Emile666/Brew_HW_Stm8s207/img/brew_hw_stm8s207_v401.png

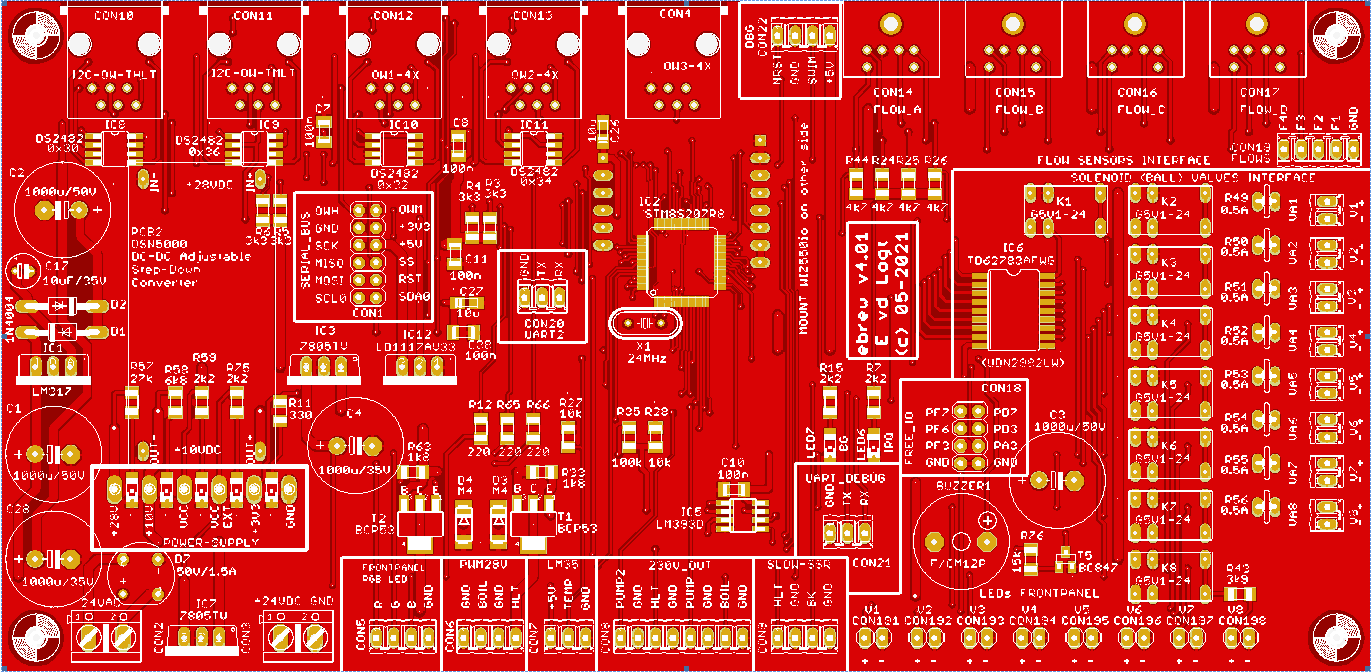
img/brew_hw_stm8s207_v401.png
