Emile666/Brew_HW_Stm8s207/pwm.c

/*==================================================================
  File Name: pwm.c
  Author   : Emile
  ------------------------------------------------------------------
  Purpose  : STM8 PWM routines
  ------------------------------------------------------------------
  This file is free software: you can redistribute it and/or modify
  it under the terms of the GNU General Public License as published by
  the Free Software Foundation, either version 3 of the License, or
  (at your option) any later version.
 
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
  You should have received a copy of the GNU General Public License
  along with this software.  If not, see <http://www.gnu.org/licenses/>.
  ================================================================== */ 
#include "pwm.h"

/*------------------------------------------------------------------
  Purpose  : This function writes a duty-cycle to a timer, so that a
             PWM signal is generated.
             There are two timers used, each with two channels:
             Timer 1, f = 16 kHz, used for the modulating gas-valves
             - channel 1: HLT_PWM
             - channel 2: BK_PWM
             Timer 3, f = 1 Hz, used for the slow-PWM/SSR signals
             - channel 1: HLT_SSR
             - channel 2: BK_SSR
             Both timers expect a duty-cycle in E-1 %.
  Variables:
       pwm_ch: [PWM_HLT, PWM_BK], the PWM timer to write to
   duty_cycle: The duty_cycle for the timers, value between [0%,100%]
  Returns  : -
  ------------------------------------------------------------------*/
void pwm_write(uint8_t pwm_ch, uint8_t duty_cycle) // duty_cyle varies 0 % and 100 %
{
    uint8_t lsb,msb;
    uint16_t temp;

    // A low-value pulls the base of the BC640 transistor low, so that
    // it starts to conducts. Inverted Logic!
    temp = 10 * (uint16_t)duty_cycle; // timers expect a duty-cycle in E-1 %.
    msb  = (temp >> 8);
    lsb  = temp & 0xFF;
    if (pwm_ch == PWM_HLT)
    {   // HLT
        TIM1_CCR1H = msb; //  msb, write this first
        TIM1_CCR1L = lsb; //  lsb
        TIM3_CCR1H = msb; //  msb, write this first
        TIM3_CCR1L = lsb; //  lsb
    } // if
    else
    {   // Boil-kettle
        TIM1_CCR2H = msb; //  msb, write this first
        TIM1_CCR2L = lsb; //  lsb
        TIM3_CCR2H = msb; //  msb, write this first
        TIM3_CCR2L = lsb; //  lsb
    } // else
} // pwm_write()
