Emile666/Brew_HW_Stm8s207/(commit log)

2023-03-26 All serial interfaces debugged and tested
    Works with PCB HW v4.01.
    Scheduler tasks now set correctly.
    MAX_MA reduced from 10 to 4.
    Two phase electric heating for BK and HLT added.
    UART1: adjustable baudrate + rx-irq bug solved
    SPI: now works at 6 MHz, tested with W550io PCB
    ADC: bug-fix rounding after averaging.
    PWM: works for slow and fast PWM
    I2C: reads ds2482 and lm92 temps correctly.
    OW: one-wire temp read correctly.
    TODO: flow-sensors.
    [adc.c, brew_stm8s207.c, brew_stm8s207.h, command_interpreter.c, command_interpreter.h, scheduler.h, spi.c, stm8_hw_init.c]
2023-10-02 R2.03: MAX7219 and Ethernet now work together
    MAX7219 only works with the 8x8 shield, not yet with the Frontpanel LEDs PCB.
2026-04-12 V2.06: Update of I2C and OW routines
    - Up to 2 DS18B20 temp. sensors are supported on HLT and MLT DS2482 channels.
    - I2C0 clock frequency increased. Task duration is now 37 msec (100 max.) for 2 One-Wire sensors and 19 msec for 1 sensor.
    - Bugfix OW_reset(): if DS2482 was not present, I2C stop was not given.
    - DS2482 devices are fixed to I2C_CH0.
    - OW ROM_IDs with their temperatures are now all printed with S3 command. ROM_IDs also printed to UART on power-up.
    [brew_stm8s207.c, command_interpreter.c, command_interpreter.h, i2c_bb.c, i2c_bb.h, one_wire.c, one_wire.h]
2026-04-26 R2.07: ultrasonic sensor on UART3 added
    - A02YYUW ultransonic distance sensor UART 9600,N,8,1 outputs 4 bytes every 100 msec., UART3 is used for this now.
    - Better One-Wire fault detection.
