Emile666/Brew_HW_Stm8s207/(notices)

Notices in the files:
Udp.c:
MIT License:
Copyright (c) 2008 Bjoern Hartmann
